starry-m/H750_ADCDAC/pic/1.jpg

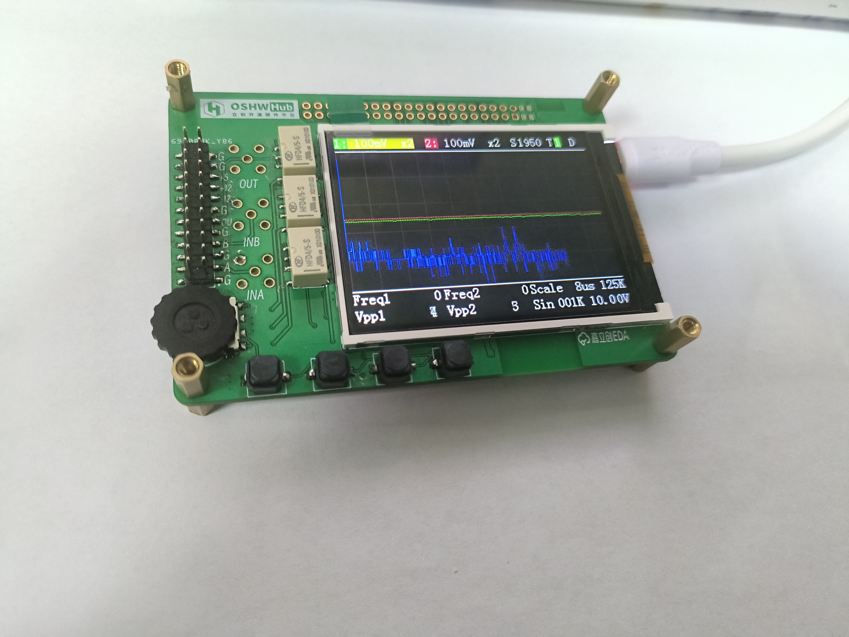
pic/1.jpg
