starry-m/H750_ADCDAC/pic/电源.png

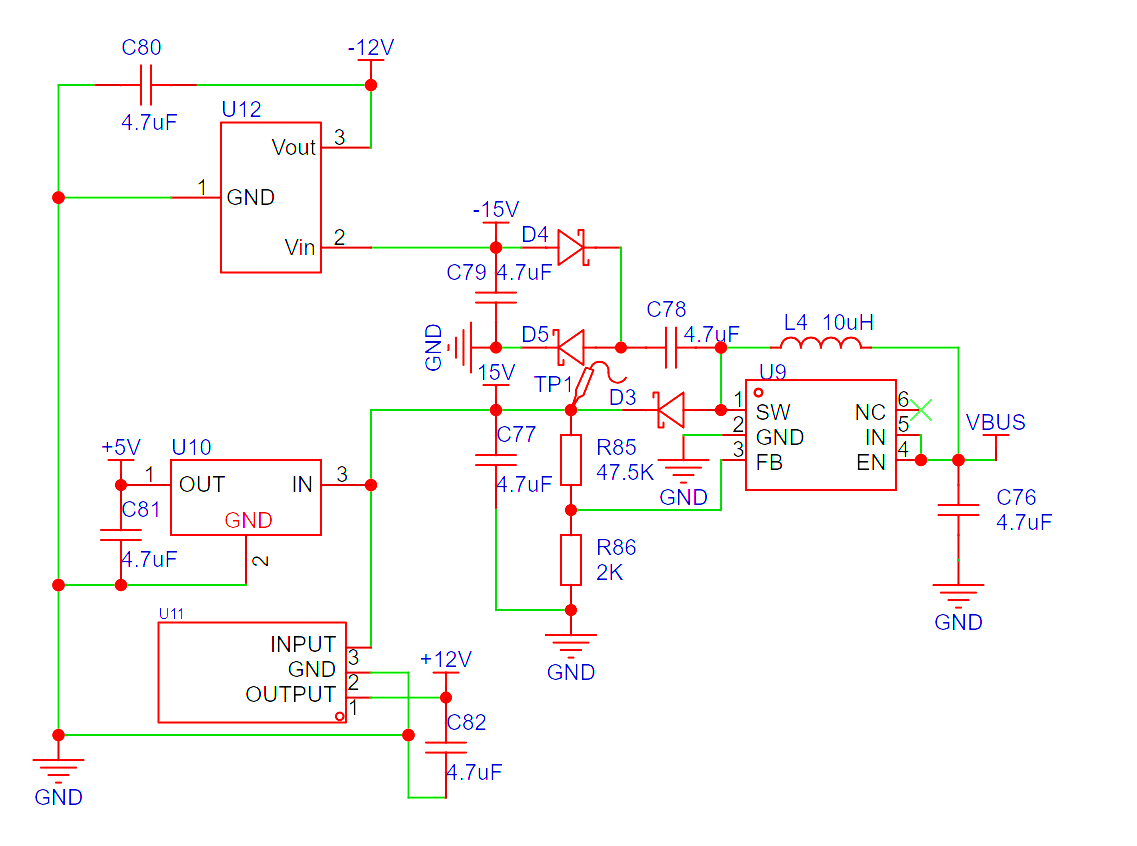
pic/电源.png
