starry-m/H750_ADCDAC/DAC.ioc

Mcu.UserName=STM32H750VBTx
PA0.Signal=S_TIM2_CH1_ETR
PA1.Signal=S_TIM2_CH2
PA10.Signal=USART1_RX
PA4.Signal=COMP_DAC11_group
PA5.Signal=COMP_DAC12_group
PA6.Signal=S_TIM3_CH1
PA7.Signal=S_TIM3_CH2
PA9.Signal=USART1_TX
PB0.Signal=GPIO_Output
PB1.Signal=ADCx_INP5
PB14.Signal=GPIO_Output
PC10.Signal=SDMMC1_D2
PC11.Signal=SDMMC1_D3
PC12.Signal=SDMMC1_CK
PC4.Signal=ADCx_INP4
PC5.Signal=GPIO_Output
PC6.Signal=USART6_TX
PC7.Signal=USART6_RX
PC8.Signal=SDMMC1_D0
PC9.Signal=SDMMC1_D1
PD2.Signal=SDMMC1_CMD
PE10.Signal=GPIO_Output
PE11.Signal=GPIO_Output
PE12.Signal=SPI4_SCK
PE13.Signal=GPIO_Output
PE14.Signal=SPI4_MOSI
PE15.Signal=GPIO_Output
PE3.Signal=GPIO_Input
PE4.Signal=GPIO_Input
PE5.Signal=GPIO_Input
PE6.Signal=GPIO_Input
PE7.Signal=GPIO_Output
PE8.Signal=GPIO_Output
PE9.Signal=GPIO_Output
