starry-m/H750_ADCDAC/USER/LCD/lcd_init.c

#include "LCD/lcd_init.h"
#include "DELAY/delay.h"
#include "spi.h"

SPI_HandleTypeDef *oled_spi = &hspi4; 


/******************************************************************************
      函数说明：LCD串行数据写入函数
      入口数据：dat  要写入的串行数据
      返回值：  无
******************************************************************************/
void LCD_Writ_Bus(uint8_t dat) 
{
	HAL_SPI_Transmit(oled_spi,&dat,1,2);
}

/******************************************************************************
      函数说明：LCD写入数据
      入口数据：dat 写入的数据
      返回值：  无
******************************************************************************/
void LCD_WR_DATA8(uint8_t dat)
{
	LCD_Writ_Bus(dat);
}


/******************************************************************************
      函数说明：LCD写入数据
      入口数据：dat 写入的数据
      返回值：  无
******************************************************************************/
void LCD_WR_DATA(uint16_t dat)
{
	LCD_Writ_Bus(dat>>8);
	LCD_Writ_Bus(dat);
}


/******************************************************************************
      函数说明：LCD写入命令
      入口数据：dat 写入的命令
      返回值：  无
******************************************************************************/
void LCD_WR_REG(uint8_t dat)
{
	LCD_DC_Clr();//写命令
	LCD_Writ_Bus(dat);
	LCD_DC_Set();//写数据
}


/******************************************************************************
      函数说明：设置起始和结束地址
      入口数据：x1,x2 设置列的起始和结束地址
                y1,y2 设置行的起始和结束地址
      返回值：  无
******************************************************************************/
void LCD_Address_Set(uint16_t x1,uint16_t y1,uint16_t x2,uint16_t y2)
{
	if(USE_HORIZONTAL==0)
	{
		LCD_WR_REG(0x2a);//列地址设置
		LCD_WR_DATA(x1);
		LCD_WR_DATA(x2);
		LCD_WR_REG(0x2b);//行地址设置
		LCD_WR_DATA(y1);
		LCD_WR_DATA(y2);
		LCD_WR_REG(0x2c);//储存器写
	}
	//Alter
		else if(USE_HORIZONTAL==1)
	{
		LCD_WR_REG(0x2a);//列地址设置
		LCD_WR_DATA(x1);
		LCD_WR_DATA(x2);
		LCD_WR_REG(0x2b);//行地址设置
		LCD_WR_DATA(y1);
		LCD_WR_DATA(y2);
		LCD_WR_REG(0x2c);//储存器写
	}
//	else if(USE_HORIZONTAL==1)
//	{
//		LCD_WR_REG(0x2a);//列地址设置
//		LCD_WR_DATA(x1);
//		LCD_WR_DATA(x2);
//		LCD_WR_REG(0x2b);//行地址设置
//		LCD_WR_DATA(y1+80);
//		LCD_WR_DATA(y2+80);
//		LCD_WR_REG(0x2c);//储存器写
//	}
	else if(USE_HORIZONTAL==2)
	{
		LCD_WR_REG(0x2a);//列地址设置
		LCD_WR_DATA(x1);
		LCD_WR_DATA(x2);
		LCD_WR_REG(0x2b);//行地址设置
		LCD_WR_DATA(y1);
		LCD_WR_DATA(y2);
		LCD_WR_REG(0x2c);//储存器写
	}
	//Alter
		else
	{
		LCD_WR_REG(0x2a);//列地址设置
		LCD_WR_DATA(x1);
		LCD_WR_DATA(x2);
		LCD_WR_REG(0x2b);//行地址设置
		LCD_WR_DATA(y1);
		LCD_WR_DATA(y2);
		LCD_WR_REG(0x2c);//储存器写
	}
//	else
//	{
//		LCD_WR_REG(0x2a);//列地址设置
//		LCD_WR_DATA(x1+80);
//		LCD_WR_DATA(x2+80);
//		LCD_WR_REG(0x2b);//行地址设置
//		LCD_WR_DATA(y1);
//		LCD_WR_DATA(y2);
//		LCD_WR_REG(0x2c);//储存器写
//	}
}

void LCD_Init(void)
{
//	LCD_GPIO_Init();//初始化GPIO
	
	LCD_RES_Clr();//复位
	delay_ms(40);
	LCD_RES_Set();
	delay_ms(20);
	
	LCD_BLK_Set();//打开背光
  delay_ms(100);
	
	//************* Start Initial Sequence **********//
//	LCD_WR_REG(0x11); //Sleep out 
	delay_ms(120);              //Delay 120ms 
	//************* Start Initial Sequence **********// 
	LCD_WR_REG(0x36);
	if(USE_HORIZONTAL==0)LCD_WR_DATA8(0x00);
	else if(USE_HORIZONTAL==1)LCD_WR_DATA8(0xC0);
	else if(USE_HORIZONTAL==2)LCD_WR_DATA8(0x70);
	else LCD_WR_DATA8(0xA0);

	LCD_WR_REG(0x3A); 
	LCD_WR_DATA8(0x05);

	LCD_WR_REG(0xB2);
	LCD_WR_DATA8(0x0C);
	LCD_WR_DATA8(0x0C);
	LCD_WR_DATA8(0x00);
	LCD_WR_DATA8(0x33);
	LCD_WR_DATA8(0x33); 

	LCD_WR_REG(0xB7); 
	LCD_WR_DATA8(0x35);  

	LCD_WR_REG(0xBB);
	LCD_WR_DATA8(0x19);

	LCD_WR_REG(0xC0);
	LCD_WR_DATA8(0x2C);

	LCD_WR_REG(0xC2);
	LCD_WR_DATA8(0x01);

	LCD_WR_REG(0xC3);
	LCD_WR_DATA8(0x12);   

	LCD_WR_REG(0xC4);
	LCD_WR_DATA8(0x20);  

	LCD_WR_REG(0xC6); 
	LCD_WR_DATA8(0x0F);    

	LCD_WR_REG(0xD0); 
	LCD_WR_DATA8(0xA4);
	LCD_WR_DATA8(0xA1);

	LCD_WR_REG(0xE0);
	LCD_WR_DATA8(0xD0);
	LCD_WR_DATA8(0x04);
	LCD_WR_DATA8(0x0D);
	LCD_WR_DATA8(0x11);
	LCD_WR_DATA8(0x13);
	LCD_WR_DATA8(0x2B);
	LCD_WR_DATA8(0x3F);
	LCD_WR_DATA8(0x54);
	LCD_WR_DATA8(0x4C);
	LCD_WR_DATA8(0x18);
	LCD_WR_DATA8(0x0D);
	LCD_WR_DATA8(0x0B);
	LCD_WR_DATA8(0x1F);
	LCD_WR_DATA8(0x23);

	LCD_WR_REG(0xE1);
	LCD_WR_DATA8(0xD0);
	LCD_WR_DATA8(0x04);
	LCD_WR_DATA8(0x0C);
	LCD_WR_DATA8(0x11);
	LCD_WR_DATA8(0x13);
	LCD_WR_DATA8(0x2C);
	LCD_WR_DATA8(0x3F);
	LCD_WR_DATA8(0x44);
	LCD_WR_DATA8(0x51);
	LCD_WR_DATA8(0x2F);
	LCD_WR_DATA8(0x1F);
	LCD_WR_DATA8(0x1F);
	LCD_WR_DATA8(0x20);
	LCD_WR_DATA8(0x23);
	
	LCD_WR_REG(0x21); 
	LCD_WR_REG(0x11); //Sleep out 
	 HAL_Delay(120); 
	LCD_WR_REG(0x29); 
} 
