starry-m/H750_ADCDAC/(commit log)

2023-11-14 移植完成，加入SD卡bmp保存
2023-11-15 截图波形失败
2023-11-15 增加SD卡DMA，解决屏幕不亮问题
2023-11-17 修改旋转编码器判定
2023-11-17 增加VOFA+波形显示
2023-11-18 蓝牙发送波形数据
2023-11-18 readme补充
