starry-m/H750_ADCDAC/(notices)

Notices in the files:
Src/bsp_driver_sd.c:
Copyright (c) 2023 STMicroelectronics.
All rights reserved.
This software is licensed under terms that can be found in the LICENSE file
